gimme1dollar/multiple-rocket-launcher/README.md

# Sphoenix
Multiple Rocket Launching Robot

## Specification
- FDM 3D printed solid rocket engine 
- Launch 6 rockets
- Motor control: P-control algorithm with absolute-encoder
- Vibration damping with rigid couplings
- Communication: RS485 module
- Ignite electrically

## Design
### System
<p align="center">
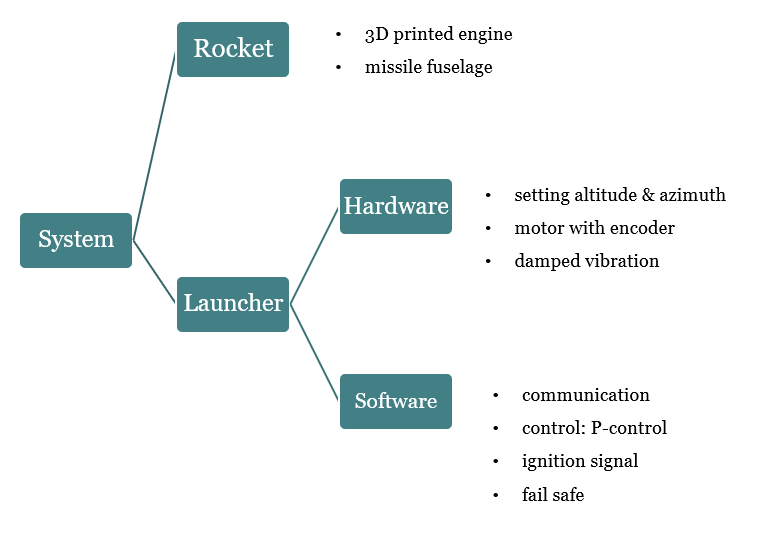
[picture p1: demo/system.PNG]

</p>

### Engine
- chamber
<p align="center">
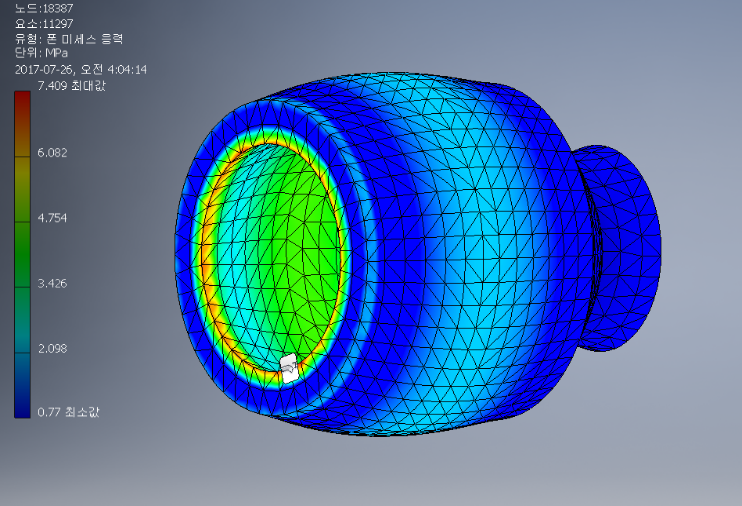
[picture p2: hardware/engine/combustion_chamber/model/PC_6mm/chamber.png]

</p>

- ejection
<p align="center">
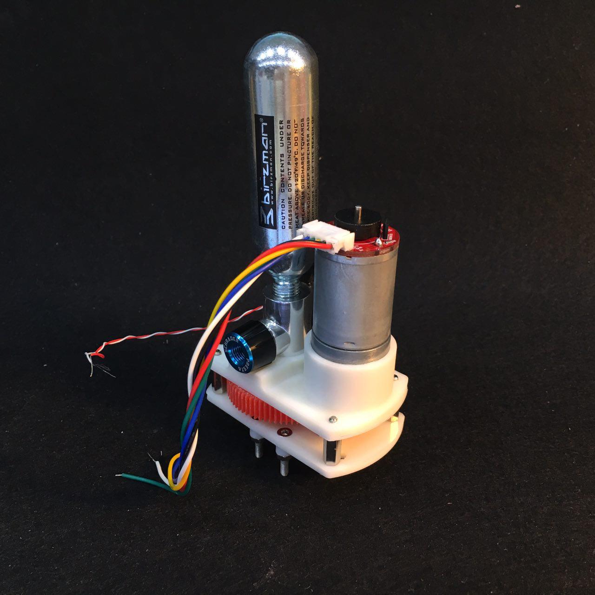
[picture p3: hardware/engine/ejection_system/v5/ejection_system_front.jpg]

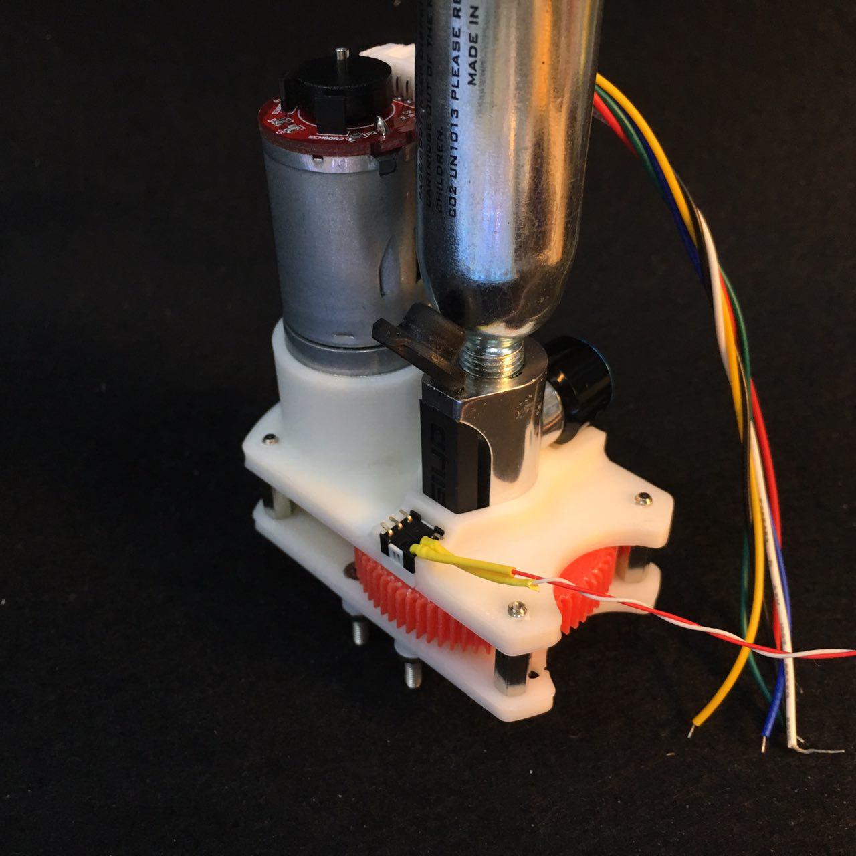
[picture p4: hardware/engine/ejection_system/v5/ejection_system_back.jpg]

</p>

### Rocket
<p align="center">

</p>

### Launcher
- model (v1)
<p align="center">
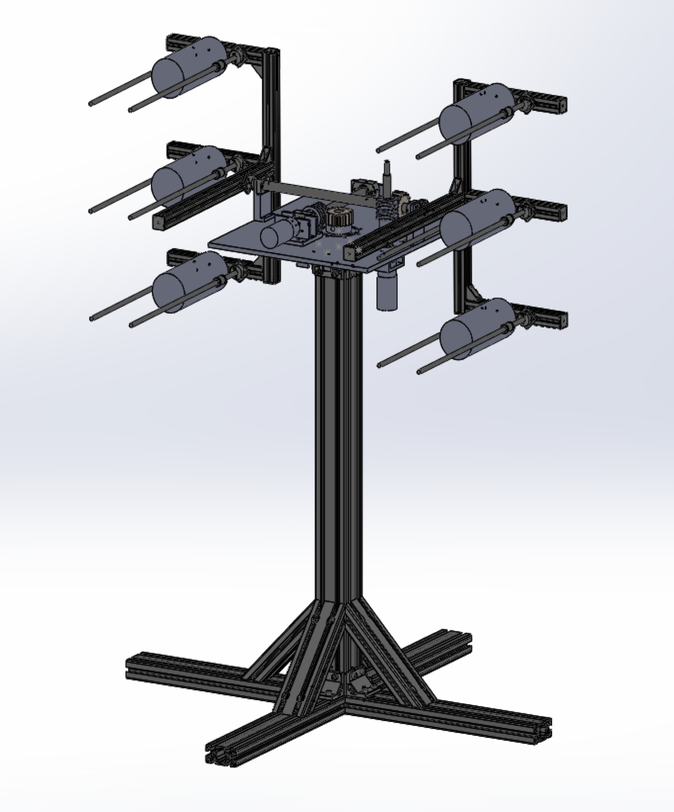
[picture p5: hardware/launcher/v1/img/model_body.png]

</p>

- prototype (v2)
<p align="center">
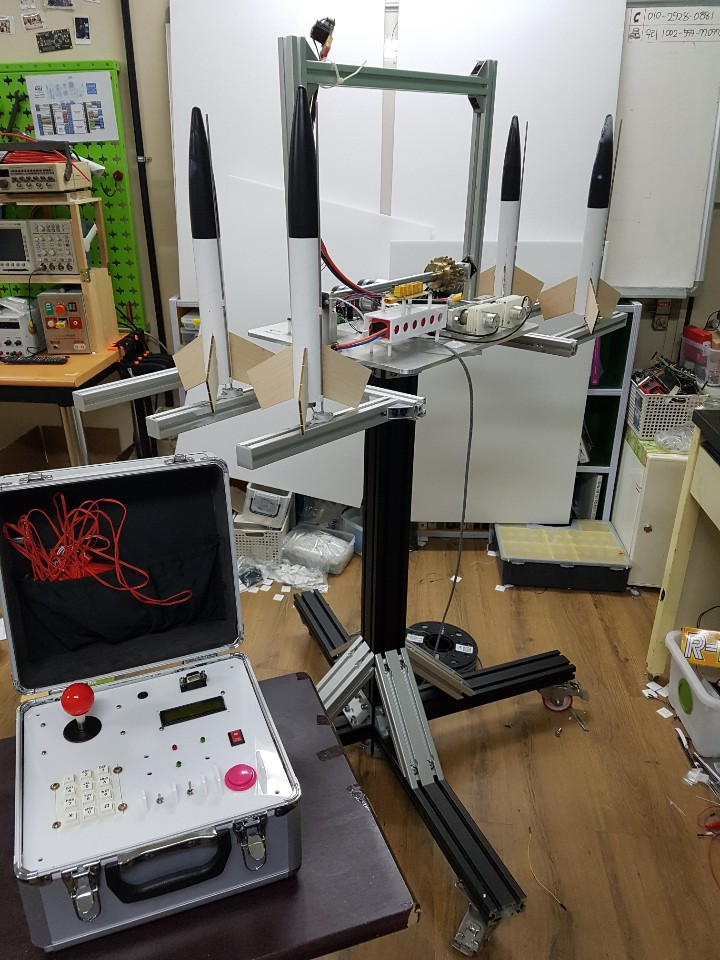
[picture p6: hardware/launcher/v2/img/body.png]

</p>
<p align="center">
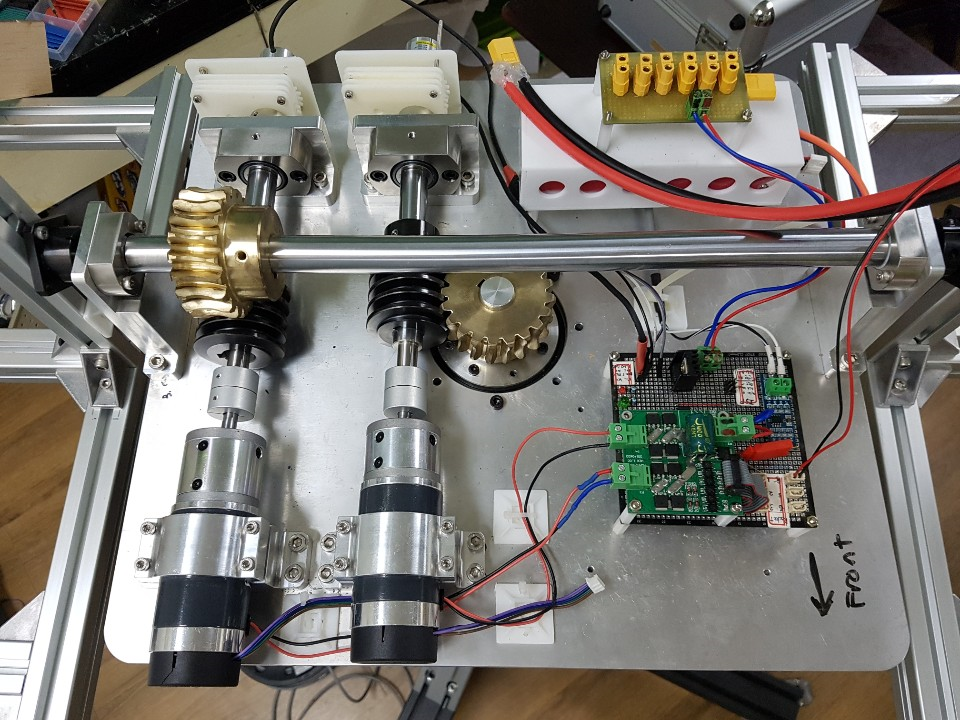
[picture p7: hardware/launcher/v2/img/gearbox.png]

</p>

## Demo
- control
<p align="center">

</p>

- thrust
<p align="center">
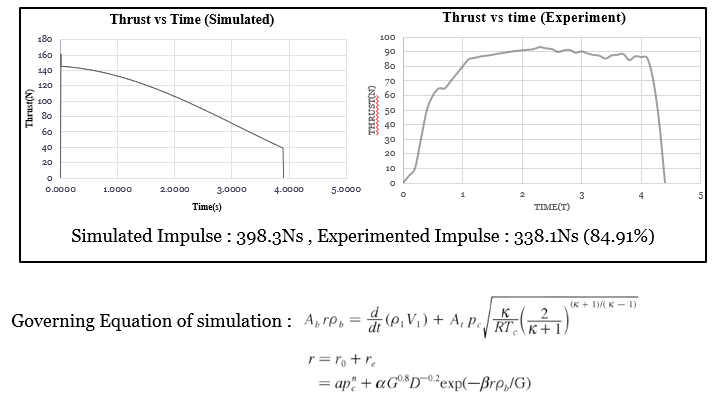
[picture p8: demo/thrust.PNG]

</p>

- launch
<p align="center">
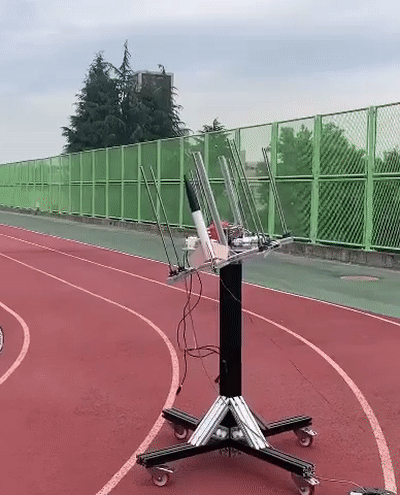
[picture p9: demo/launch.gif]

</p>

## Related works
- Project: 메이커 창작활동 지원사업 (한국과학창의재단, 2018)
- Patent: Production method of solid projectile (특허등록번호, 10-2181636-0000)

## Contributors
- 이정락 유지호 김지환 이주용 고예송     
- 이정락 김지환 유지호 김래언 이지연 민진식
