gimme1dollar/multiple-rocket-launcher/demo/combustion.png

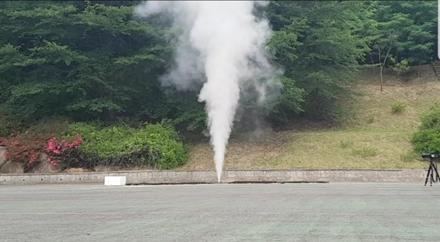
demo/combustion.png
