gimme1dollar/multiple-rocket-launcher/hardware/launcher/v1/[Sphoenix] BOM_GearBox.xlsx

설명 | 이름 | 가격 | 개수 | 총 가격 | 링크 | 비고
몸통 | HFSB8-8080-1000 | 76440 | 2 | 152880 | https://kr.misumi-ec.com/vona2/detail/110302690740/?rid=rid3 | 1m
베어링(박스) | RU85 CRBF5515 | 203480 | 2 | 406960 | http://hit10.co.kr/product/detail.html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 | inner : 55, outside : 120 (mm)
브라켓 | HBLTD8-SSP | 7480 | 16 | 119680 | https://kr.misumi-ec.com/vona2/detail/110300450220/ | 부속품 : SSP, 볼트 : M8
모터 | DS4572 | 71000 | 5 | 355000 | http://www.devicemart.co.kr/1326627 | pi 8, 전압 : 24V, 감속비 길이 : 32.5 (토크 : 1.6Kg-f-cm, 회전수 : 500RPM)
웜 | SW3-R1J18 | 74254 | 4 | 297016 | https://kr.misumi-ec.com/vona2/detail/221004937424/ | 홀 직경 : 18 pi, 모듈 3, 개수 1, 방향 R | http://www.boopoom.com/shop/item.php?it_id=KHK0266
웜 힐 | AG3-20R1J20 | 170375 | 4 | 681500 | https://kr.misumi-ec.com/vona2/detail/221004937390/ | 홀 직경 : 20 pi, 톱니 수 : 20, 개수 : 1, 모듈 3 (캐드 에서는 바깥 큰 쪽이 기어있는거임)
커플링 | GSACL25-8-12 | 9350 | 6 | 56100 | https://kr.misumi-ec.com/vona2/detail/110302540060/?HissuCode=GSACL25-8-12 | 길이 : 31, 외경 : 25, 왼쪽 : 8, 오른쪽 : 12
리니어 샤프트 : 수직 | PSSFGH18-120-F30-P12-M5-T30 | 23210 | 2 | 46420 | https://kr.misumi-ec.com/vona2/detail/110302559930/ | 양단, 재질 SUS, 축 직경 : 18 pi, P : 12mm, 길이 120mm (F/T : 30mm, 암나사 5)
리니어 샤프트 : 수평 | PSSFGH18-280-F30-P12-M5-T30 | 29070 | 2 | 58140 | https://kr.misumi-ec.com/vona2/detail/110302559930/ | 양단, 재질 SUS, 축 직경 : 18 pi, P : 12mm, 길이 280mm (F/T : 30mm, 암나사 5) | http://www.boopoom.com/shop/item.php?it_id=KHK0195
리니어 샤프트 : 로켓 | PSSFGH20-390-F40-P10-M5-T40 | 29070 | 2 | 58140 | https://kr.misumi-ec.com/vona2/detail/110302559930/ | 양단, 재질 SUS, 축 직경 : 20 pi, P : 10mm, 길이 390mm (F/T : 30mm, 암나사 5)
베어링 : 웜기어 | SBGCS12 | 89540 | 6 | 537240 | https://kr.misumi-ec.com/vona2/detail/110300101010/?CategorySpec=00000029694%3a%3ab | 내경 : 12mm, 길이 23mm, SUS (캐드 상에서 내경이 반지름으로 표시되는데 확인해볼것. 캐드 그래서 내경 7짜리임)
베어링 : 로켓 | SBGTA6000ZZ | 33090 | 4 | 132360 | https://kr.misumi-ec.com/vona2/detail/110300099950/?CategorySpec=00000029691%3a%3ab | 내경 : 10mm, 길이 13mm, SUS
볼트-M8 | M8-25 | 14710 | 1 | 14710 | https://kr.misumi-ec.com/vona2/detail/221005179131/?KWSearch=m8&searchFlow=results2products | 길이 : 25, 1묶음 :100개
볼트-M6 | M6-30 | 20430 | 1 | 20430 | https://kr.misumi-ec.com/vona2/detail/221005179120/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 | 길이 : 30, 1묶음 :100개 |  | 길이 : 25
볼트-M4 | M4-40 | 16410 | 1 | 16410 | https://kr.misumi-ec.com/vona2/detail/221005179120/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 | 길이 : 40, 1묶음 :100개
너트-M8 | KNTRF8 | 390 | 100 | 39000 | https://kr.misumi-ec.com/vona2/detail/110300250540/ | 두께 : 5
너트-M6 | KNTRF6 | 360 | 100 | 36000 | https://kr.misumi-ec.com/vona2/detail/110300250540/ | 두께 : 3.6 | 두꺼운 걸로??
너트-M4 | LBNR4 | 230 | 100 | 23000 | https://kr.misumi-ec.com/vona2/detail/110300250540/ | 두께 : 2.4, 넓이 : 7
support center RU85 |  | 150000 | 2 | 300000 |  | 포스텍 기기가공실
support down leg |  | 200000 | 1 | 200000 |  | 포스텍 기기가공실
support down RU85 |  | 100000 | 1 | 100000 |  | 포스텍 기기가공실
support middle bearing |  | 100000 | 2 | 200000 |  | 포스텍 기기가공실
support rotating fraction |  | 100000 | 2 | 200000 |  | 포스텍 기기가공실
support side bearing box |  | 100000 | 2 | 200000 |  | 포스텍 기기가공실
support side bearing rocket |  | 150000 | 3 | 450000 |  | 포스텍 기기가공실
support side motor rocket |  | 150000 | 2 | 300000 |  | 포스텍 기기가공실
다리 | HFSB8-4080-500 | 20930 | 4 | 83720 | https://kr.misumi-ec.com/vona2/detail/110302690310/ | 50cm
다리 보강용 브라켓 | GFBL8-4080-200 | 49400 | 4 | 197600 | https://kr.misumi-ec.com/vona2/detail/110302371970/ | 20cm
프레임용 볼트 | HCBST8-24 | 910 | 20 | 18200 | https://kr.misumi-ec.com/vona2/detail/110300463770/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
 |  |  |  | 5147626
 |  | hcbst8-24
